Paka-bot/2-axis-articulated-robotic-arm-with-custom-PCB/README.md

(https://projects.engineering.oregonstate.edu/projects/?id=NPUBsuqH4jg9Jg8b)
