Paka-bot/2-axis-articulated-robotic-arm-with-custom-PCB/hardware/JD2_kicad_library/3d_model/DCJ235_05_A_K1_K (2)/dcj235-05-a-k1-k_reva.step

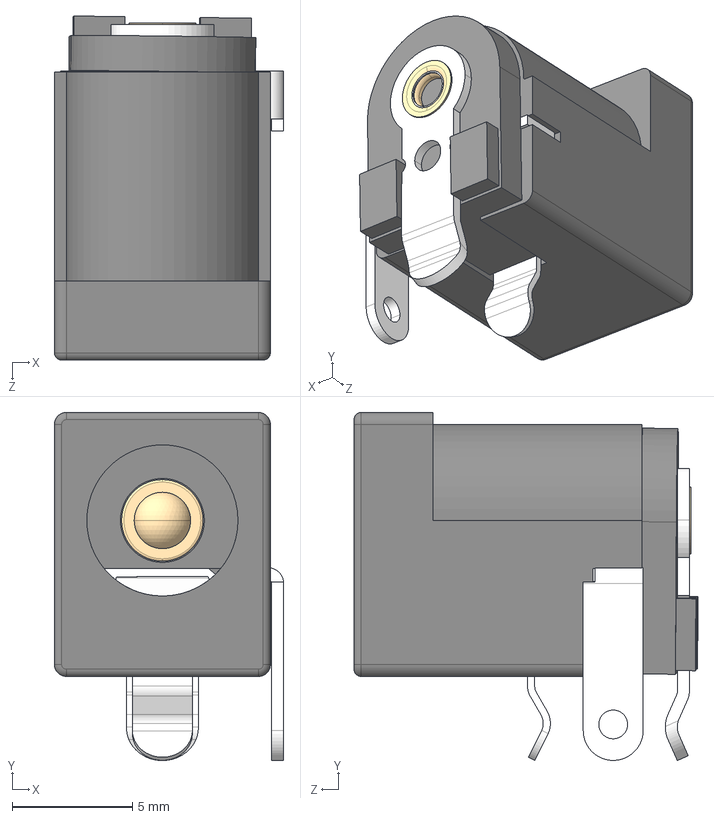
[picture p31: CAD file, 2026-09-03]
hardware/JD2_kicad_library/3d_model/DCJ235_05_A_K1_K (2)/dcj235-05-a-k1-k_reva.step
9.55 x 14.5 x 14.3 mm
DCJ235-05-01
DCJ235-05-03
DCJ235-05-02
DCJ235-05-center pin
DCJ235-05-housing-black
DCJ235-05-cover-black
