Paka-bot/2-axis-articulated-robotic-arm-with-custom-PCB/software/sim/Two-axis robotic arm pcb simulation.asc

C1: Cap; 100µ
C2: Cap; 220µ
L1: Ind; 33µH
R1: Res; 25
U1: d1n5822
U2: LM2596_5P0_TRANS
V1: Voltage; 12
Named nets: 0, Vout, SW, Voltreg_MC_dcpwr, Voltreg_MD_dcpwr
.include LM2596_5P0_TRANS.LIB
.tran 0 20m
.include 1n5822.lib.txt
