Paka-bot/2-axis-articulated-robotic-arm-with-custom-PCB/hardware/Robotics_Arm/Robotics_Arm.kicad_pcb

## KiCad design hardware/Robotics_Arm/Robotics_Arm.kicad_pcb (2026-09-03)

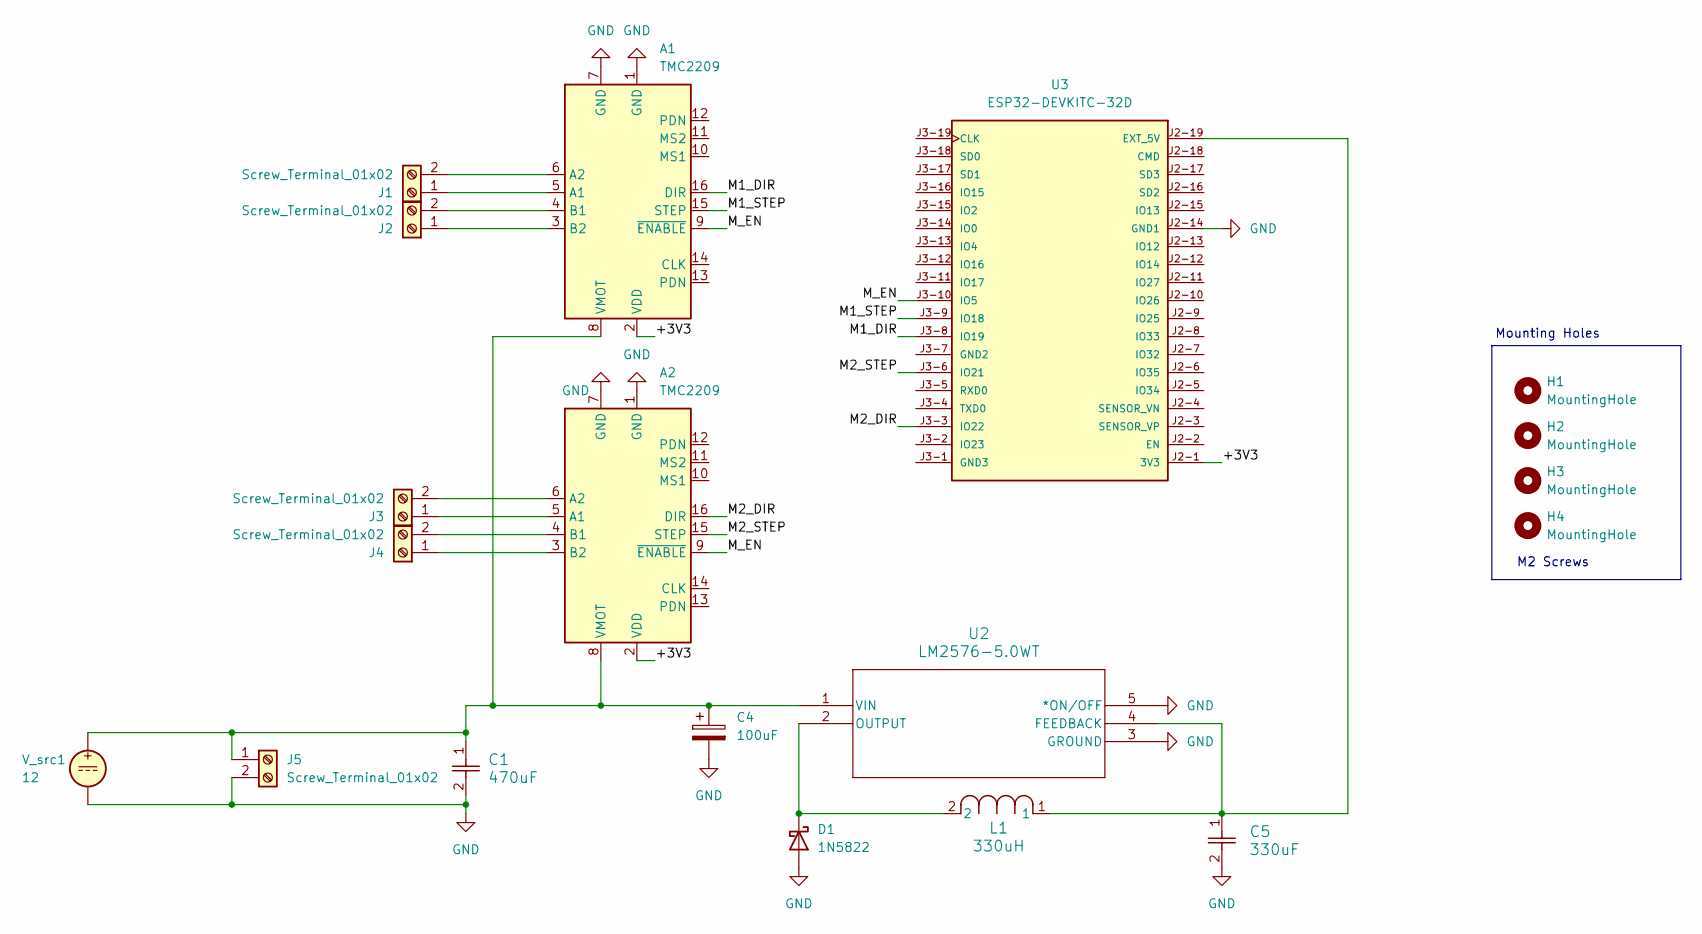
[picture p32: schematic Robotics_Arm.kicad_sch, Linear Voltage Regulator for Motor Driver and MCU]

Parts:
A1, A2: TMC2209; Pololu_Breakout-16_15.2x20.3mm
C1: 470uF; CAP_10 X 16_NCH
C4: 100uF; CP_Radial_D5.0mm_P2.00mm
C5: 330uF; CAP_PAN_10X12.5_PAN
D1: 1N5822
H1, H2, H3, H4: MountingHole; MountingHole_2.2mm_M2
J1, J2, J3, J4, J5: Screw_Terminal_01x02; TerminalBlock_TE_282834-2_1x02_P2.54mm_Horizontal
L1: 330uH; IND_PE-53117NL_PUL
U2: LM2576-5.0WT; TO-220-5_P3.4x3.7mm_StaggerEven_Lead3.8mm_Vertical
U3: ESP32-DEVKITC-32D; MODULE_ESP32-DEVKITC-32D; PARTREV V4
V_src1: 12

Connections:
/+3V3: A1.2 (VDD), A2.2 (VDD), U3.J2-1 (3V3)
/M1_DIR: A1.16 (DIR), U3.J3-8 (IO19)
/M1_STEP: A1.15 (STEP), U3.J3-9 (IO18)
/M2_DIR: A2.16 (DIR), U3.J3-3 (IO22)
/M2_STEP: A2.15 (STEP), U3.J3-6 (IO21)
/M_EN: A1.9 (~ENABLE), A2.9 (~ENABLE), U3.J3-10 (IO5)
GND: A1.1 (GND), A1.7 (GND), A2.1 (GND), A2.7 (GND), C1.2, C4.2, C5.2, D1.2 (A), J5.2, U2.3 (GROUND), U2.5 (*ON/OFF), U3.J2-14 (GND1), V_src1.2
unnamed: A1.5 (A1), J1.1
unnamed: A1.6 (A2), J1.2
unnamed: A1.4 (B1), J2.2
unnamed: A1.3 (B2), J2.1
unnamed: A1.8 (VMOT), A2.8 (VMOT), C1.1, C4.1, J5.1, U2.1 (VIN), V_src1.1
unnamed: A2.5 (A1), J3.1
unnamed: A2.6 (A2), J3.2
unnamed: A2.4 (B1), J4.2
unnamed: A2.3 (B2), J4.1
unnamed: D1.1 (K), L1.2, U2.2 (OUTPUT)
unnamed: C5.1, L1.1, U2.4 (FEEDBACK), U3.J2-19 (EXT_5V)

Notes on the sheet:
Mounting Holes
M2 Screws

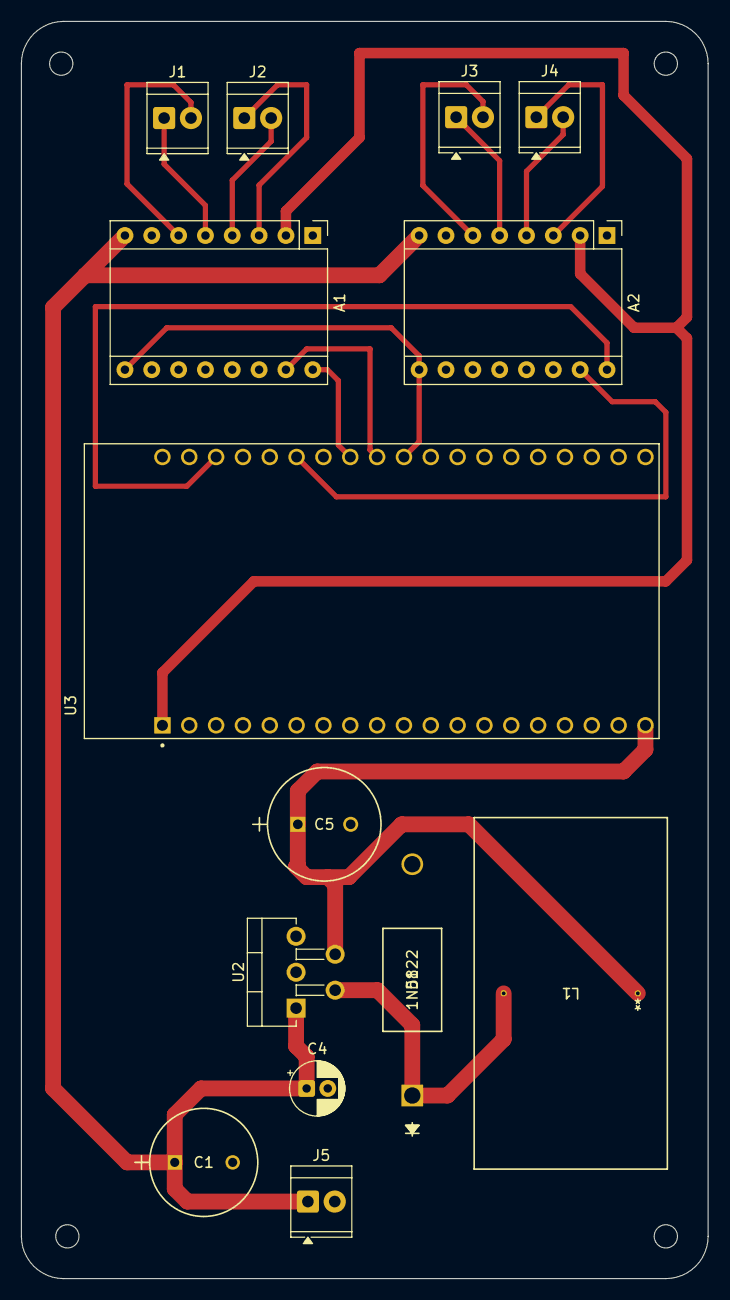
[picture p33: board Robotics_Arm.kicad_pcb from above]

Board: 2 copper layers, 65.0 x 119.0 mm, 18 parts (0 on the bottom side), 18 nets.
