Paka-bot/2-axis-articulated-robotic-arm-with-custom-PCB/docu/ref/SCARA project.kicad_pcb

## KiCad design docu/ref/SCARA project.kicad_pcb (2026-09-03)

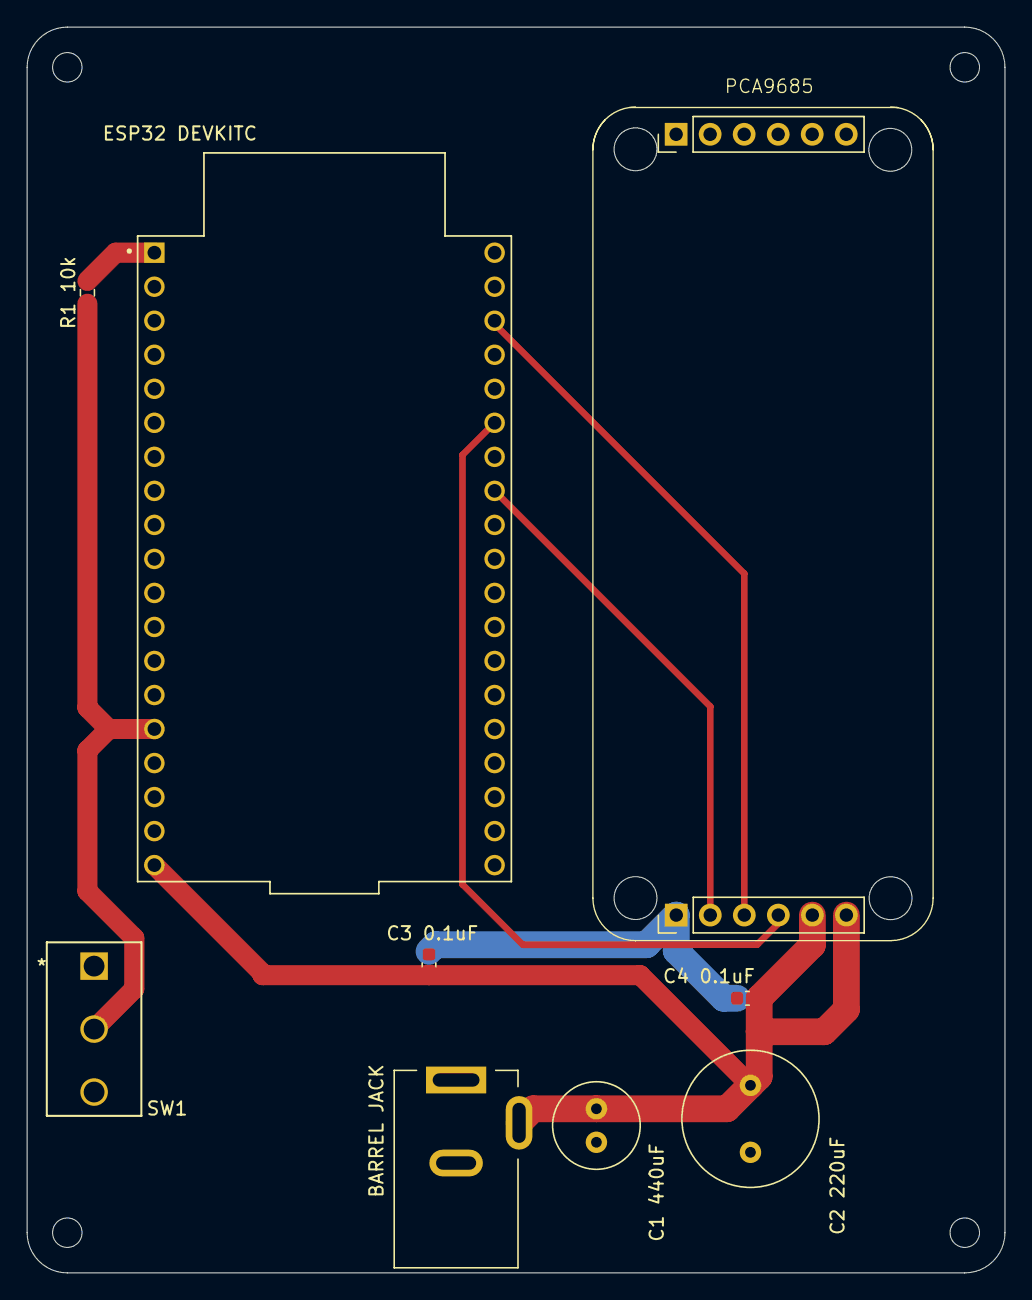
[picture p34: board SCARA project.kicad_pcb from above]

Board: 2 copper layers, 73.0 x 93.0 mm, 18 parts (0 on the bottom side), 7 nets.

Parts:
BARREL JACK: DCJ235-05-A-K1-K; BarrelJack_Kycon_KLDX-0202-xC_Horizontal
C1 440uF: 470uF; C_Radial_D6.3mm_H7.0mm_P2.50mm
C2 220uF: 220uF; C_Radial_D10.0mm_H12.5mm_P5.00mm
C3 0.1uF, C4 0.1uF: 0.1uF; C_0603_1608Metric
ESP32 DEVKITC: ESP32-DEVKITC; MODULE_ESP32-DEVKITC
H1, H2, H3, H4: MountingHole; MountingHole_2.2mm_M2
H5, H6, H7, H8: MountingHole; MountingHole_3.2mm_M3
J1, J2: Conn_01x06_Socket; PinHeader_1x06_P2.54mm_Vertical
R1 10k: 10k; R_0603_1608Metric
SW1: SLW-1276864-4A-D; SLW-1276864_CUD

Connections:
GND: BARREL JACK.2, C1 440uF.2, C2 220uF.2, C3 0.1uF.2, C4 0.1uF.2, ESP32 DEVKITC.14 (GND1), J2.1, SW1.1
unnamed: ESP32 DEVKITC.31 (IO19), J2.2
unnamed: ESP32 DEVKITC.36 (IO22), J2.3
unnamed: ESP32 DEVKITC.33 (IO21), J2.4
unnamed: BARREL JACK.3, C1 440uF.1, C2 220uF.1, C3 0.1uF.1, C4 0.1uF.1, ESP32 DEVKITC.19 (EXT_5V), J2.5, J2.6
unnamed: ESP32 DEVKITC.1 (3V3), R1 10k.2
unnamed: ESP32 DEVKITC.15 (IO13), R1 10k.1, SW1.2
