Paka-bot/2-axis-articulated-robotic-arm-with-custom-PCB/(notices)

Notices in the files:
parts and their libraries:
Copyright 2016 Accelerated Designs. All rights reserved.
